wagiminator/CH32X033-USB-NRF/hardware/USB2NRF_BOM.tsv

ID | Name | Designator | Footprint | Quantity | Manufacturer Part | Manufacturer | Supplier | Supplier Part
1 | 100n | C1 | C_0603 | 1 | CC0603KRX7R9BB104 | YAGEO | LCSC | C14663
2 | 10u | C2 | C_0603 | 1 | CL10A106KP8NNNC | SAMSUNG | LCSC | C19702
3 | 1u | C3,C4 | C_0603 | 2 | CL10A105KB8NNNC | SAMSUNG(三星) | LCSC | C15849
4 | BUSY | LED1 | LED0603 | 1 | KT-0603R | KENTO | LCSC | C2286
5 | PWR | LED2 | LED0603 | 1 | 19-217/GHC-YR1S2/3T | EVERLIGHT | LCSC | C72043
6 | 1k | R1,R2,R3 | 0603 | 3 | 0603WAF1001T5E | UniOhm | LCSC | C21190
7 | BOOT | SW1 | SW-SMD_L4.0-W2.9-LS5.0 | 1 | YTS1T0092CBG00 | YIYUAN(怡远) | LCSC | C5221275
8 | CH32X033F8P6 | U1 | TSSOP-20 | 1 | CH32X033F8P6 | WCH(南京沁恒) | LCSC
9 | AP2112K-3.3TRG1 | U3 | SOT-25-5 | 1 | AP2112K-3.3TRG1 | DIODES | LCSC | C51118
10 | NRF24L01 | U4 | NRF24L01+SMD | 1 | mininrf24l01 | Greatwall | aliexpress | ?
11 | USB-Plug | USB1 | USB-M-48 | 1 | USB-05 | SOFNG | LCSC | C112454
