wagiminator/CH32X033-USB-NRF/software/nrf2cdc/src/main.c

// ===================================================================================
// Project:   NRF2CDC for nRF24L01+ 2.4GHz Transceiver USB Stick based on CH32X033
// Version:   v1.0
// Year:      2024
// Author:    Stefan Wagner
// Github:    https://github.com/wagiminator
// EasyEDA:   https://easyeda.com/wagiminator
// License:   http://creativecommons.org/licenses/by-sa/3.0/
// ===================================================================================
//
// Description:
// ------------
// NRF2CDC is a simple development tool for wireless applications based on the
// nRF24L01+ 2.4GHz transceiver module. It provides a serial interface for
// communication with the module via USB CDC.
//
// References:
// -----------
// - WCH Nanjing Qinheng Microelectronics: http://wch.cn
//
// Compilation Instructions:
// -------------------------
// - Make sure GCC toolchain (gcc-riscv64-unknown-elf, newlib) and Python3 with chprog
//   are installed. In addition, Linux requires access rights to the USB bootloader.
// - Press the BOOT button on the MCU board and keep it pressed while connecting it
//   via USB to your PC.
// - Run 'make flash'.
//
// Operating Instructions:
// -----------------------
// Plug the device into a USB port, it should be detected as a CDC device. Open a 
// serial monitor, BAUD rate doesn't matter. Enter the text to be sent, terminated
// with a Newline (NL or '\ n'). A string that begins with an exclamation mark ('!')
// is recognized as a command. The command is given by the letter following the
// exclamation mark. Command arguments are appended as bytes in 2-digit hexadecimal
// directly after the command. The following commands can be used to set the NRF:
//
// cmd  description       example         example description
// -----------------------------------------------------------------------------------
//  c   set channel       !c2A            set channel to 0x2A (0x00 - 0x7F)
//  t   set TX address    !t7B271F1F1F    addresses are 5 bytes, LSB first
//  r   set RX address    !r41C355AA55    addresses are 5 bytes, LSB first
//  s   set speed         !s02            data rate (00:250kbps, 01:1Mbps, 02:2Mbps)
//
// Enter just the exclamation mark ('!') for the actual NRF settings to be printed
// in the serial monitor.


// ===================================================================================
// Libraries, Definitions and Macros
// ===================================================================================
#include <config.h>                               // user configurations
#include <system.h>                               // system functions
#include <gpio.h>                                 // GPIO functions
#include <usb_cdc.h>                              // USB CDC functions
#include <nrf24l01.h>                             // nRF24L01+ functions


// Global variables
uint8_t buffer[NRF_PAYLOAD];                      // rx/tx buffer

// ===================================================================================
// Print Functions and String Conversions
// ===================================================================================

// Convert an array of bytes into hex string and print via CDC
void CDC_printBytes(uint8_t *ptr, uint8_t len) {
  while(len--) CDC_printB(*ptr++);
}

// Convert character representing a hex nibble into 4-bit value
uint8_t hexDigit(uint8_t c) {
  if     ((c >= '0') && (c <= '9')) return(c - '0');
  else if((c >= 'a') && (c <= 'f')) return(c - 'a' + 10);
  else if((c >= 'A') && (c <= 'F')) return(c - 'A' + 10); 
  return 0;
}

// Convert string containing a hex byte into 8-bit value
uint8_t hexByte(uint8_t *ptr) {
  return((hexDigit(*ptr++) << 4) + hexDigit(*ptr));
}

// Convert string containing 5 hex bytes into address array
void hexAddress(uint8_t *sptr, uint8_t *aptr) {
  uint8_t i;
  for(i=5; i; i--) {
    *aptr++ = hexByte(sptr);
    sptr += 2;
  }
}

// Print the current NRF settings via CDC
void CDC_printSettings(void) {
  CDC_println("# nRF24L01+ Configuration:");
  CDC_print  ("# RF channel: "); CDC_printB    (NRF_channel);    CDC_write('\n');
  CDC_print  ("# TX address: "); CDC_printBytes(NRF_tx_addr, 5); CDC_write('\n');
  CDC_print  ("# RX address: "); CDC_printBytes(NRF_rx_addr, 5); CDC_write('\n');
  CDC_print  ("# Data rate:  "); CDC_print(NRF_STR[NRF_speed]);  CDC_println("bps");
}

// ===================================================================================
// Command Parser
// ===================================================================================
void parse(void) {
  uint8_t cmd = buffer[1];                          // read the command
  switch(cmd) {                                     // what command?
    case 'c': NRF_channel = hexByte(buffer + 2) & 0x7F;
              break;
    case 't': hexAddress(buffer + 2, NRF_tx_addr);
              break;
    case 'r': hexAddress(buffer + 2, NRF_rx_addr);
              break;
    case 's': NRF_speed = hexByte(buffer + 2);
              if(NRF_speed > 2) NRF_speed = 2;
              break;
    default:  break;
  }
  NRF_configure();                                  // reconfigure the NRF
  CDC_printSettings();                              // print settings via CDC
}

// ===================================================================================
// Main Function
// ===================================================================================
int main(void) {
  // Variables
  uint8_t buflen;                                   // data length in buffer
  uint8_t bufptr;                                   // buffer pointer

  // Setup
  CDC_init();                                       // init USB CDC
  NRF_init();                                       // init nRF24L01+
  PIN_output(PIN_LED);                              // set LED pin to output

  // Loop
  while(1) {
    PIN_high(PIN_LED);                              // switch off LED

    if(NRF_available()) {                           // something coming in via NRF?
      PIN_low(PIN_LED);                             // switch on LED
      bufptr = 0;                                   // reset buffer pointer
      buflen = NRF_readPayload(buffer);             // read payload into buffer
      while(buflen--) CDC_write(buffer[bufptr++]);  // write buffer via USB CDC
      CDC_flush();                                  // flush CDC
    }

    buflen = CDC_available();                       // get number of bytes in CDC IN
    if(buflen) {                                    // something coming in via USB?
      bufptr = 0;                                   // reset buffer pointer
      if(buflen > NRF_PAYLOAD) buflen = NRF_PAYLOAD;// restrict length to max payload
      while(buflen--) buffer[bufptr++] = CDC_read();// get data from CDC
      if(buffer[0] == CMD_IDENT) parse();           // is it a command? -> parse
      else {                                        // not a command?
        PIN_low(PIN_LED);                           // switch on LED
        NRF_writePayload(buffer, bufptr);           // send the buffer via NRF
      }
    }
  }
}
